svvsdIC/Canary-Electrical/README.md

# Canary-Electrical
Board files and schematics for Canary project
