svvsdIC/Canary-Electrical/Project Canary V4.6.brd

## EAGLE design Project Canary V4.6.brd (2019-06-13)

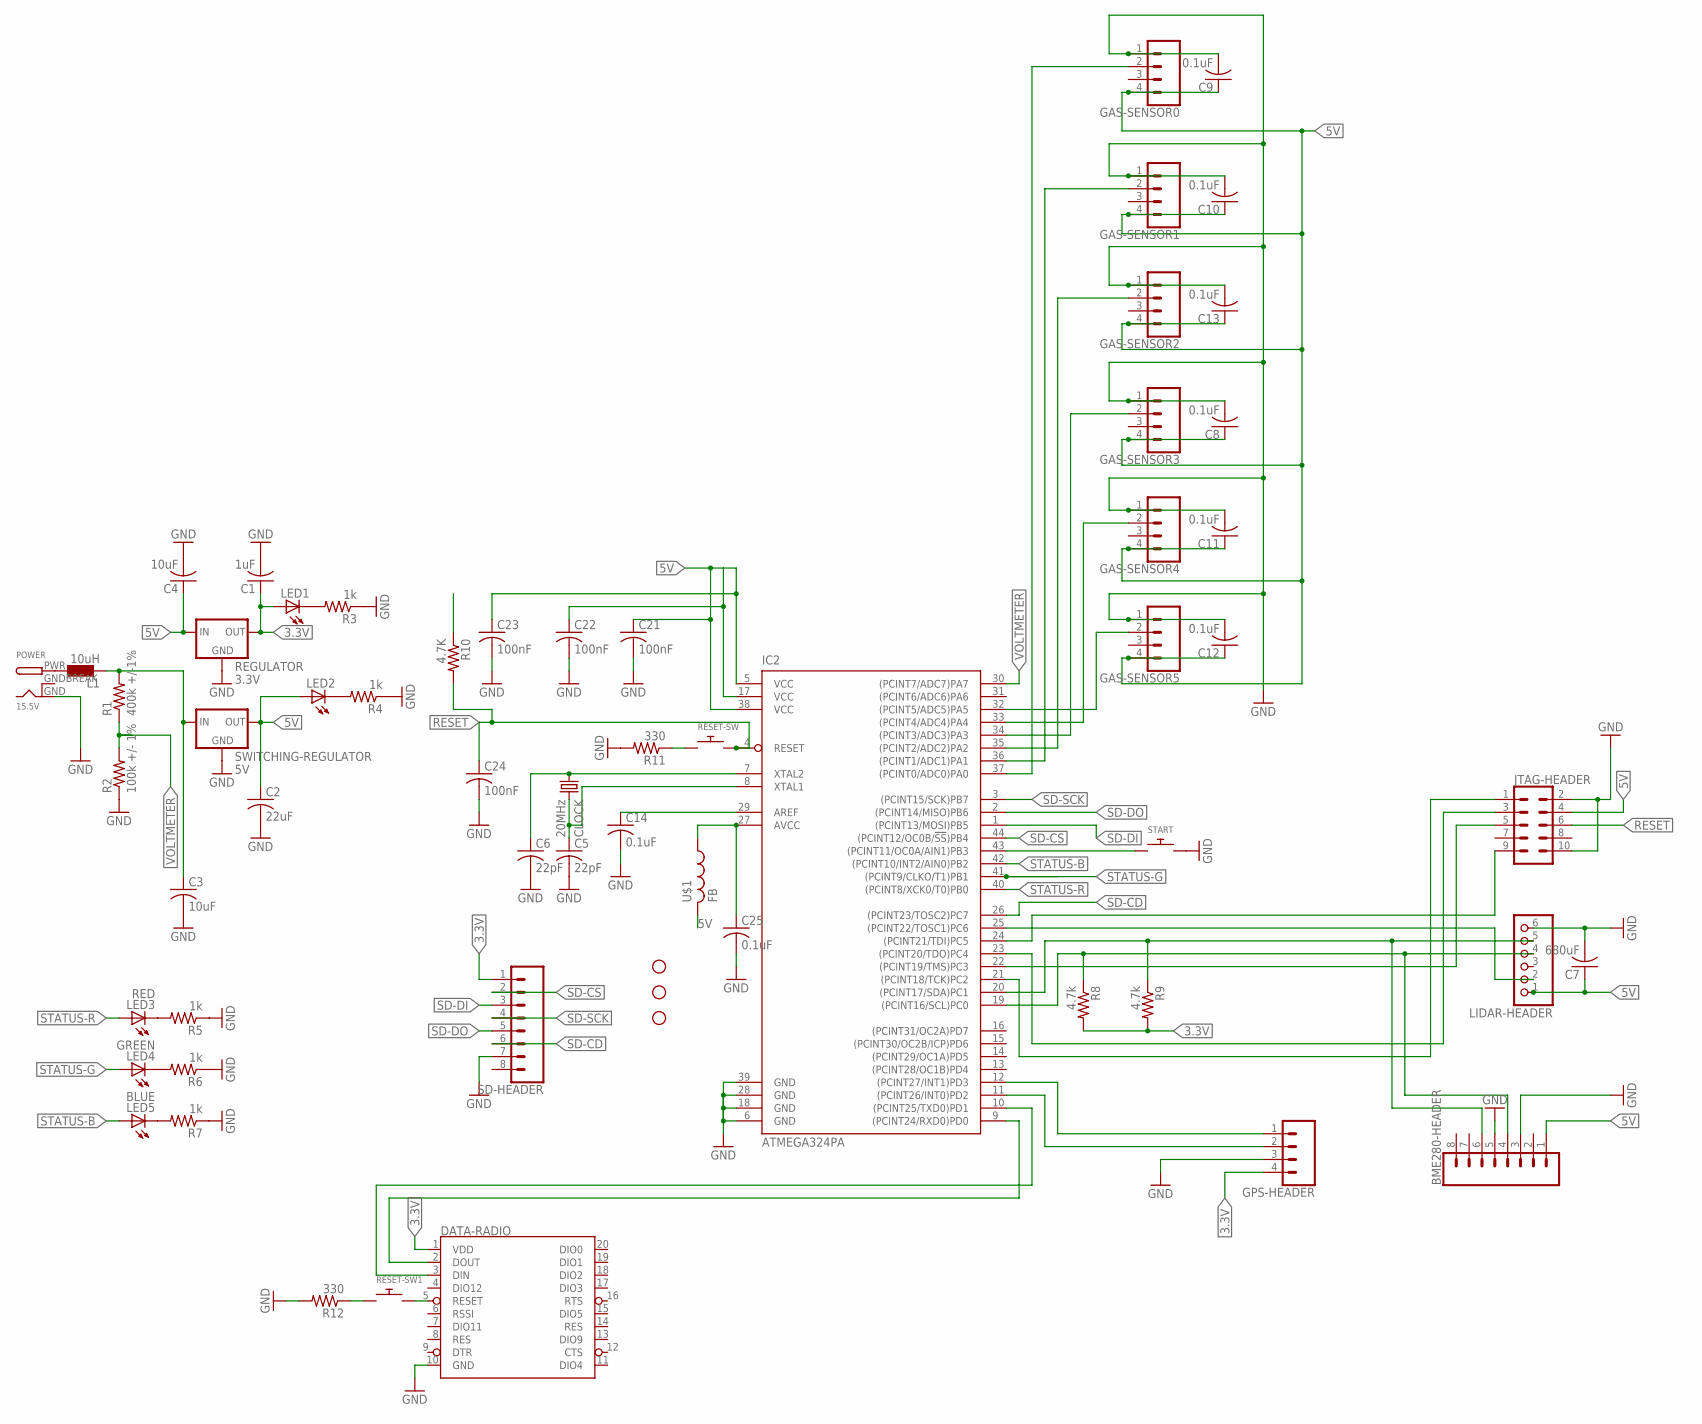
[picture p1: schematic Project Canary V4.6.sch]

Parts:
BME280-HEADER: CONN_08"; 1X08
C1: 1uF; C0805
C2: 22uF; C0603
C3: 10uF; C0805
C4: 10uF; C0603
C5, C6: 22pF; C0603
C7: 680uF; C0603
C8, C9, C10, C11, C12, C13, C14, C25: 0.1uF; C0603
C21, C22, C23: 100nF; C0603
C24: 100nF; C0805
CLOCK: 20MHz; 86SMX
DATA-RADIO: XBEE
GAS-SENSOR0, GAS-SENSOR1, GAS-SENSOR2, GAS-SENSOR3, GAS-SENSOR4, GAS-SENSOR5: CONN_04; 1X04
GPS-HEADER: CONN_04; 1X04
IC2: ATMEGA324PA; TQFP44
JTAG-HEADER: CONN_05X2PTH; 2X5
L1: 10uH; L1812
LED1, LED2: LEDCHIP-LED0805; CHIP-LED0805
LED3: RED; CHIP-LED0805
LED4: GREEN; CHIP-LED0805
LED5: BLUE; CHIP-LED0805
LIDAR-HEADER: PINHD-1X6; 1X06
MOUNT-HOLE1, MOUNT-HOLE2, MOUNT-HOLE3: STAND-OFF
POWER: 15.5V; DCJACK_2MM_PTH
R1: 400k +/-1%; M0805
R2: 100k +/- 1%; M0805
R3, R4, R5, R6, R7: 1k; M0805
R8, R9: 4.7k; M0805
R10: 4.7K; M0805
R11, R12: 330; M0805
REGULATOR: 3.3V; TO220-IGO
RESET-SW, RESET-SW1: SWITCH_PUSHBUTTONSOFTTOUCHSMD_SJ; PUSHBUTTON_SMD_SJ
SD-HEADER: CONN_08"; 1X08
START: SWITCH_PUSHBUTTONSOFTTOUCHSMD_SJ; PUSHBUTTON_SMD_SJ
SWITCHING-REGULATOR: 5V; TO220-IGO
U$1: FB

Connections:
3.3V: C1.1, DATA-RADIO.1 (VDD), GPS-HEADER.4, LED1.A, R8.2, R9.2, REGULATOR.OUT, SD-HEADER.1
5V: BME280-HEADER.1, C2.1, C4.1, C7.1, C8.1, C9.1, C10.1, C11.1, C12.1, C13.1, C21.1, C22.1, C23.1, GAS-SENSOR0.4, GAS-SENSOR1.4, GAS-SENSOR2.4, GAS-SENSOR3.4, GAS-SENSOR4.4, GAS-SENSOR5.4, IC2.5 (VCC), IC2.17 (VCC), IC2.38 (VCC), JTAG-HEADER.4, LED2.A, LIDAR-HEADER.1, REGULATOR.IN, SWITCHING-REGULATOR.OUT, U$1.P$2 (2)
GND: BME280-HEADER.3, BME280-HEADER.5, C1.2, C2.2, C3.2, C4.2, C5.2, C6.2, C7.2, C8.2, C9.2, C10.2, C11.2, C12.2, C13.2, C14.2, C21.2, C22.2, C23.2, C24.2, C25.2, DATA-RADIO.10 (GND), GAS-SENSOR0.1, GAS-SENSOR1.1, GAS-SENSOR2.1, GAS-SENSOR3.1, GAS-SENSOR4.1, GAS-SENSOR5.1, GPS-HEADER.3, IC2.6 (GND), IC2.18 (GND), IC2.28 (GND), IC2.39 (GND), JTAG-HEADER.2, JTAG-HEADER.10, LIDAR-HEADER.6, POWER.GND, R2.1, R3.1, R4.1, R5.1, R6.1, R7.1, R11.2, R12.2, REGULATOR.GND, SD-HEADER.7, START.P$2, SWITCHING-REGULATOR.GND
GNDBREAK: POWER.GNDBREAK
unnamed: C3.1, L1.2, R1.2, SWITCHING-REGULATOR.IN
unnamed: LED1.C, R3.2
unnamed: LED2.C, R4.2
unnamed: LED3.C, R5.2
unnamed: LED4.C, R6.2
unnamed: LED5.C, R7.2
unnamed: IC2.43 ((PCINT11/OC0A/AIN1)PB3), START.P$1
unnamed: C6.1, CLOCK.1, IC2.7 (XTAL2)
unnamed: C25.1, IC2.27 (AVCC), U$1.P$1 (1)
unnamed: GPS-HEADER.1, IC2.12 ((PCINT27/INT1)PD3)
unnamed: GPS-HEADER.2, IC2.11 ((PCINT26/INT0)PD2)
unnamed: GAS-SENSOR0.2, IC2.37 ((PCINT0/ADC0)PA0)
unnamed: IC2.25 ((PCINT22/TOSC1)PC6), LIDAR-HEADER.2
unnamed: IC2.24 ((PCINT21/TDI)PC5), JTAG-HEADER.9
unnamed: C14.1, IC2.29 (AREF)
unnamed: GAS-SENSOR1.2, IC2.36 ((PCINT1/ADC1)PA1)
unnamed: GAS-SENSOR2.2, IC2.35 ((PCINT2/ADC2)PA2)
unnamed: GAS-SENSOR3.2, IC2.34 ((PCINT3/ADC3)PA3)
unnamed: GAS-SENSOR4.2, IC2.33 ((PCINT4/ADC4)PA4)
unnamed: GAS-SENSOR5.2, IC2.32 ((PCINT5/ADC5)PA5)
unnamed: BME280-HEADER.4, IC2.19 ((PCINT16/SCL)PC0), LIDAR-HEADER.4, R8.1
unnamed: L1.1, POWER.PWR
unnamed: IC2.23 ((PCINT20/TDO)PC4), JTAG-HEADER.3
unnamed: BME280-HEADER.6, IC2.20 ((PCINT17/SDA)PC1), LIDAR-HEADER.5, R9.1
unnamed: IC2.22 ((PCINT19/TMS)PC3), JTAG-HEADER.5
unnamed: DATA-RADIO.3 (DIN), IC2.10 ((PCINT25/TXD0)PD1)
unnamed: DATA-RADIO.2 (DOUT), IC2.9 ((PCINT24/RXD0)PD0)
unnamed: IC2.21 ((PCINT18/TCK)PC2), JTAG-HEADER.1
unnamed: DATA-RADIO.5 (RESET), RESET-SW1.P$2
unnamed: R11.1, RESET-SW.P$1
unnamed: C5.1, CLOCK.4 (2), IC2.8 (XTAL1)
unnamed: R12.1, RESET-SW1.P$1
RESET: C24.1, IC2.4 (RESET), JTAG-HEADER.6, R10.2, RESET-SW.P$2
SD-CD: IC2.26 ((PCINT23/TOSC2)PC7), SD-HEADER.6
SD-CS: IC2.44 ((PCINT12/OC0B/!SS!)PB4), SD-HEADER.2
SD-DI: IC2.1 ((PCINT13/MOSI)PB5), SD-HEADER.3
SD-DO: IC2.2 ((PCINT14/MISO)PB6), SD-HEADER.5
SD-SCK: IC2.3 ((PCINT15/SCK)PB7), SD-HEADER.4
STATUS-B: IC2.42 ((PCINT10/INT2/AIN0)PB2), LED5.A
STATUS-G: IC2.41 ((PCINT9/CLKO/T1)PB1), LED4.A
STATUS-R: IC2.40 ((PCINT8/XCK0/T0)PB0), LED3.A
VOLTMETER: IC2.30 ((PCINT7/ADC7)PA7), R1.1, R2.2

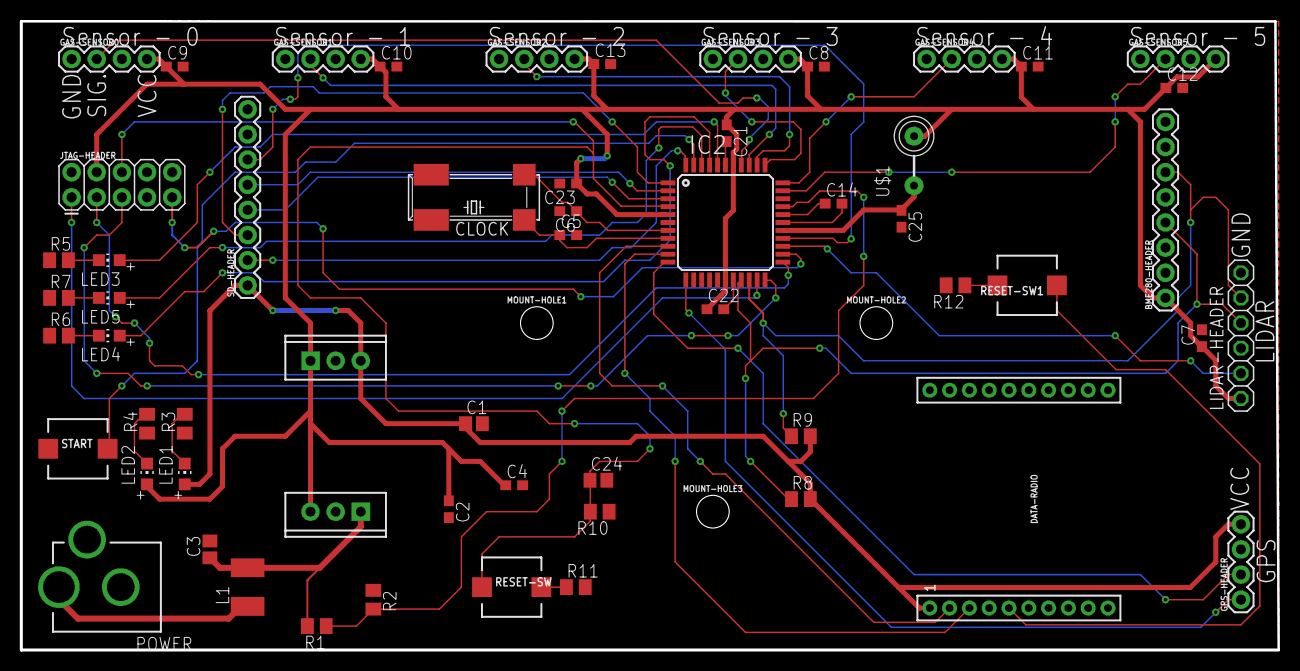
[picture p2: board Project Canary V4.6.brd from above]

Board: 2 copper layers, 127.0 x 63.5 mm, 61 parts (0 on the bottom side), 45 nets.
