svvsdIC/Canary-Electrical/(threads)

Thread 1 (2018-10-08):

Trace width on power input (too small at 0.006 inch)

lewispg228, 2018-10-08:
The traces at your initial power input are a little too thin. At 0.006 inch width, they have the potential to heat up (and eventually burn up) if too much current is pulled.

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

I would suggest bumping up the trace width on all of these segments to at least 0.020 inch like so:

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

You can use the "change" tool (looks like a wrench), then select width and "0.02", then start clicking all the segments of the traces to change their width.

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

samuelguava, 2018-10-13:
Hey Pete, I changed the width to .024 inches, just to be safe. Should I also change the width of the N$1 signal going down at that fork in the circuit?

lewispg228, 2018-10-15:
Hey @samuelguava Could you commit (and push) your changes?

> Should I also change the width of the N$1 signal going down at that fork in the circuit?

Probably not necessary, as that is only heading down to a voltage divider (400K/100K) for reference. That won't see much current at all.

> I was just checking the ERC and using the Errors tool, and they came up with a multitude of errors for both the schematic and board. Should those be of any concern?

Depends, but I think you're okay.

Looking at the currently committed design (v4.3), there are a ton of width errors on all of your traces. This is because they are all included in your net class "5V", which is requiring at least 20 mils (0.020 inch). The proper way to set this up would be to use a "default" net class of 0.006 inch for all your data lines, and then only include your 5V net in the 5V net class.

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

And I wouldn't worry about your "wire stub" errors. These are just due to funny routing that is hard to see because it's all "under" a pad.

If you ever want to see what the DRC errors are talking about, try double clicking on them from the "DRC Errors" window, (while having the brd file open). It will navigate to the error and highlight it with an angled line and box.

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

As far as ERC errors in your schematic/brd, I wouldn't worry about those.  When you have a lot of unconnected pins on symbols, Eagle will throw a lot of ERC errors. As long as they are intentional, you can ignore them (or "approve" them in the error window).

Although, I might put a reset button (pull down to GND) on your Xbee reset line. That might come in handy if you want to reset the module without having to cycle power by unplugging and re-plugging in your barrel jack power input.

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

lewispg228, 2018-10-16:
Trace width increased. Looks good. However, reset grounding has created another issue.

Closed 2018-10-16.

Thread 2 (2018-10-08):

Pin labels on the board silk will be very useful

lewispg228, 2018-10-08:
It would be great to put some labels on all of your header pins, but especially the sensor 4-pin headers.
It would be fatal if these were plugged in backwards and VCC/GND were swapped!!

Also, this could help a ton when plugging things in for the first time and troubleshooting in the field.

Currently, your board is "blank". If you'd like to put somesilk on the design, then you need to add text objects to your "tPlace" layer in eagle. To do this, use the text object tool (looks like a letter "A"). Type in your text you'd like (for example, GND), then select tPlace as your later. Then click to place.

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

And even better, it might be nice to know which port is which by labeling each like so with "sensor - #":

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

lewispg228, 2018-10-16:
Originally, I was thinking that every port would get all three pins labeled (GND/SIG/VCC), but I suppose if you look at Sensor-0 port, then you can assume they are all the same. I will leave this up to you as to whether you'd like to add more or not.

Thread 3 (2018-10-08):

Programming header for your AVR

lewispg228, 2018-10-08:
Although your current header will work, it will require individually wiring up each programming line properly (a bit of a pain). I would suggest using a more standard AVR programming header.

Your's is currently a 1X8 straight pin row.

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

Most AVR based designs use a 3x2 or 5x2 header arrangement (aka "footprint" or "package"). Like so:

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

We have this device available in our Sparkfun Eagle Libraries repo here:

https://github.com/sparkfun/SparkFun-Eagle-Libraries

The part is found in the SparkFun-Connectors.lbr

lewispg228, 2018-10-08:
whoops. I didn't see the JTAG header till just now. I'm guessing that is how you plan to program, so this AVR header is not an issue. closing.

Closed 2018-10-08.

Thread 4 (2018-10-16):

Xbee RESET line incorrectly grounded

lewispg228, 2018-10-16:
Hey Sam,
Sorry one more issue. (Sorry I wasn't more clear with this). You added a GND connection on the reset line of the Xbee module. This will keep RESET permanently grounded (in reset).

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

What I meant was for you to include one more momentary button on that line. This would be very similar to how the reset button circuit works on the Micro controller.

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
