svvsdIC/Canary-Electrical/(commit log)

2018-03-16 Initial commit of Canary board and schematic
    Added:
    -CanarySchematic3.0.brd
    - CanarySchematic3.0.sch
    [CanarySchematic3.0.brd, CanarySchematic3.0.sch]
2018-04-13 Finished circuit board layout
    Finished routing all the airwires
    Need to adjust the widths of the 5V and 3.3V airwires to allow for 1.5A and .25A, respectively
    [Project Canary V3.5.brd, Project Canary V3.5.sch]
2018-04-20 Increasing the width of the power lines
    Per Pete's advice, I increased the width of all the routes for the 3.3V and 5V lines
    Increased the isolate the top and bottom ground pours to 12 mils
    Made some minor adjustments to some of the routes
    [Project Canary V4.0.brd, Project Canary V4.0.sch]
2018-06-01 Fixed some of the DRC Errors
    * Found the two remaining airwires and routed them
    * Fixed the clearance errors on some of the resistors
    * Ended up with 482 errors for the widths of the routes
    [Project Canary V4.2.brd, Project Canary V4.2.sch]
2018-06-08 Finalizing the details of the board
    * Isolated the groundpour of the board from 10 mils to 12 mils
    * Rerouted all the lines to get rid of the DRC width errors
    [Project Canary V4.3.brd, Project Canary V4.3.sch]
2018-10-16 Final draft of Project Canary circuit board
    - Widened the power lines near the plug to 24 mils, and some routes branching off to 8 mils
    - Added labels for each of the sensors (sensor #, GND, signal, VCC), and the LIDAR and GPS headers
    [Project Canary V4.5.brd, Project Canary V4.5.sch]
2018-10-16 Final final draft of circuit board
    - Modified the reset for the data radio to match the one on the micro controller (added a reset button and 330 Ohm resistor before connecting to GND) in the schematic
    - Added routes to the reset button and resistor (R12) after placing them above the data radio on the board; the route from the radio to the reset button wraps around the GPS header
    [Project Canary V4.6.brd, Project Canary V4.6.sch]
2019-06-13 Added ground to pin 5, (bottom right)
    [Project Canary V4.6.brd, Project Canary V4.6.sch]
2019-06-13 Organized file
    [CanarySchematic3.0.brd, CanarySchematic3.0.sch, Project Canary V3.5.brd, Project Canary V3.5.sch, Project Canary V4.0.brd, Project Canary V4.0.sch, Project Canary V4.2.brd, Project Canary V4.2.sch]
2019-06-13 Fixed the Ferrite Bead and smoothed out wires
    [Project Canary V4.6.brd, Project Canary V4.6.sch]
